Meaxl/customMidiController/documentation/pictures/breadboard_1.jpeg

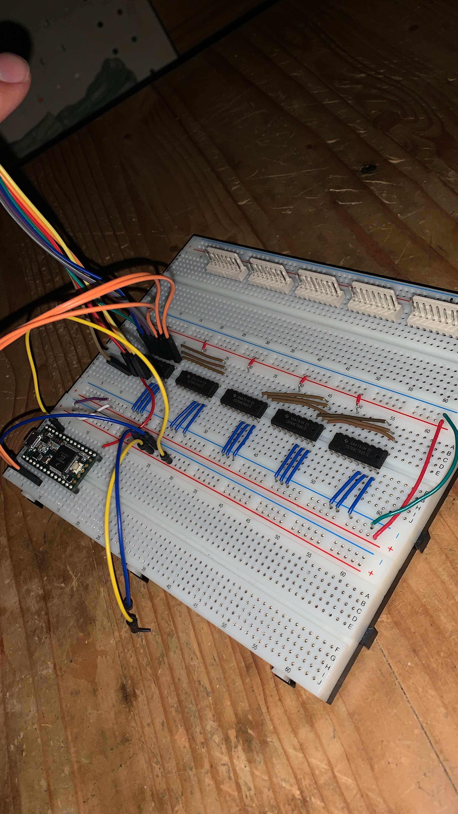
documentation/pictures/breadboard_1.jpeg
