Meaxl/customMidiController/documentation/pictures/breadboard_2.jpeg

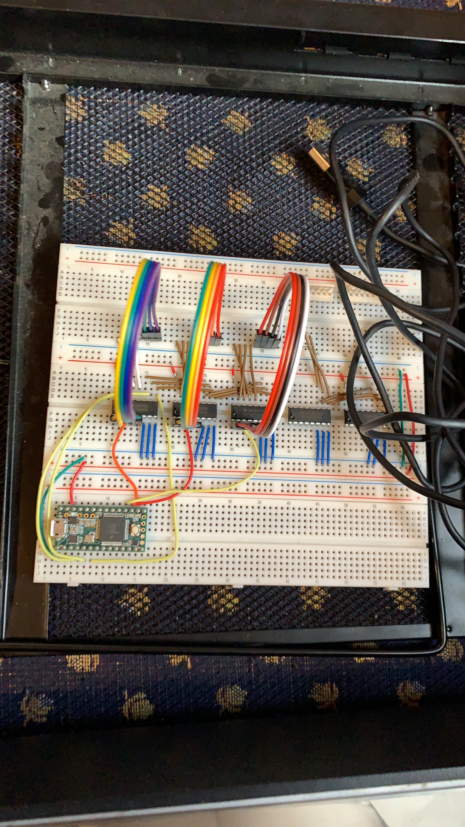
documentation/pictures/breadboard_2.jpeg
