Meaxl/customMidiController/documentation/pictures/frontplate_2.jpeg

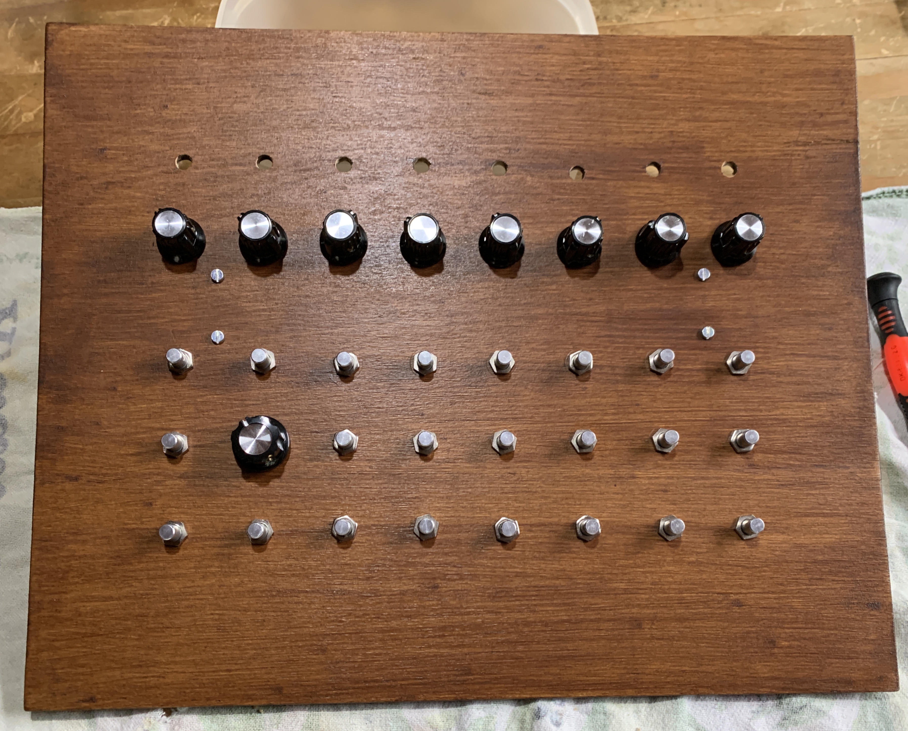
documentation/pictures/frontplate_2.jpeg
