Meaxl/customMidiController/documentation/pictures/frontplate_3.jpeg

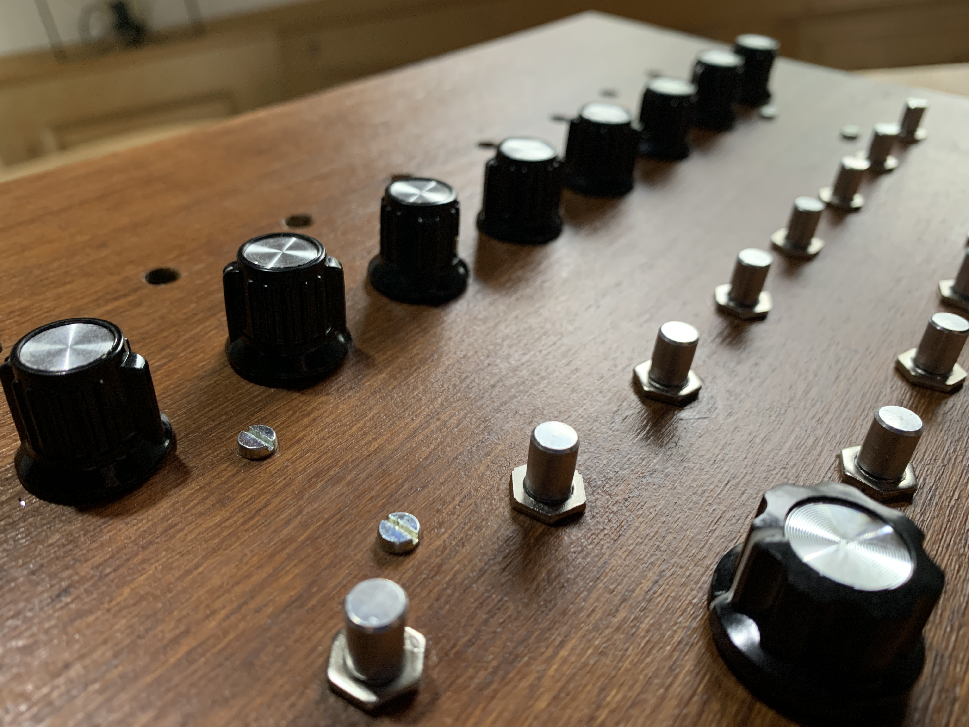
documentation/pictures/frontplate_3.jpeg
