Meaxl/customMidiController/documentation/pictures/frontplate_4.jpeg

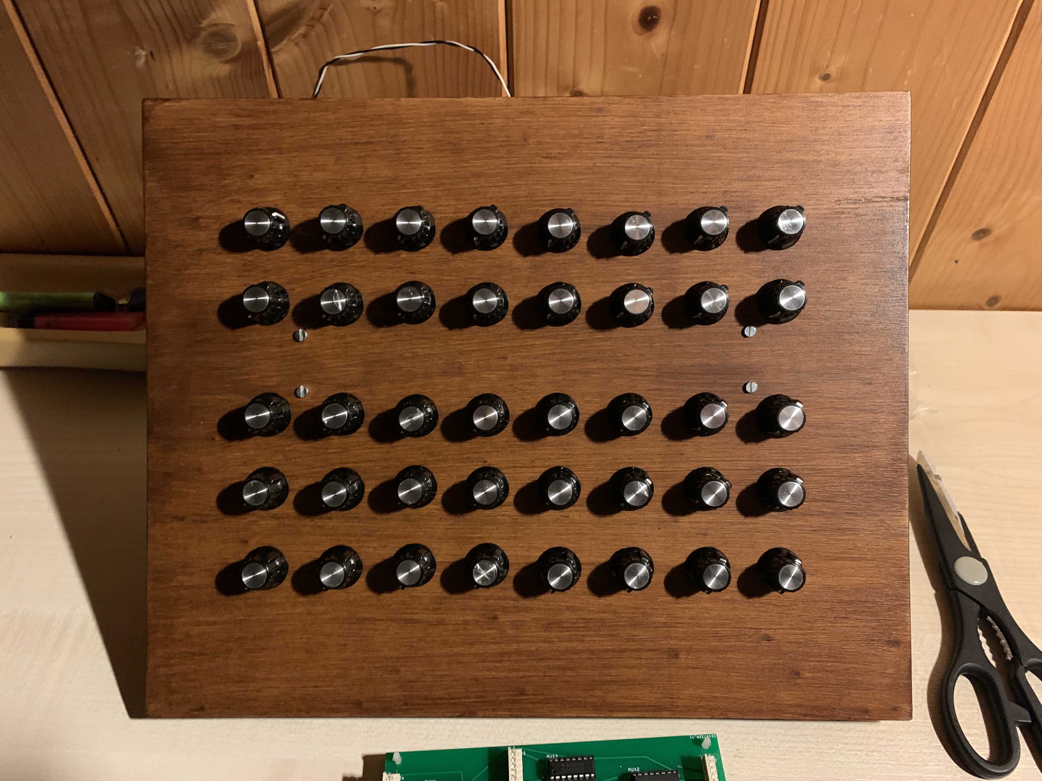
documentation/pictures/frontplate_4.jpeg
