Meaxl/customMidiController/documentation/pictures/pcb_1.jpeg

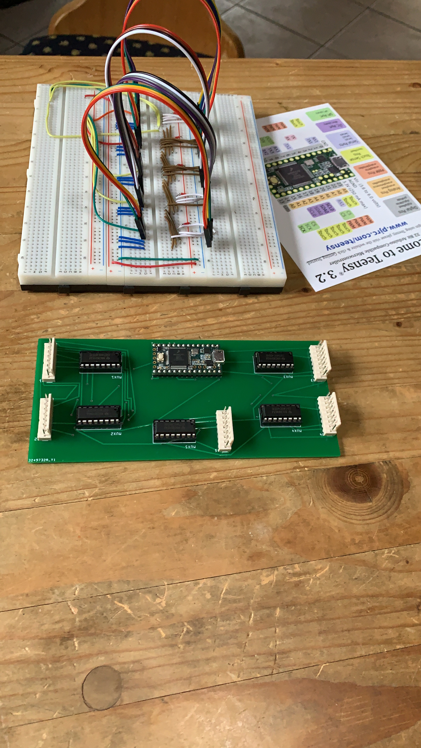
documentation/pictures/pcb_1.jpeg
