Meaxl/customMidiController/documentation/pictures/pcb_2.jpeg

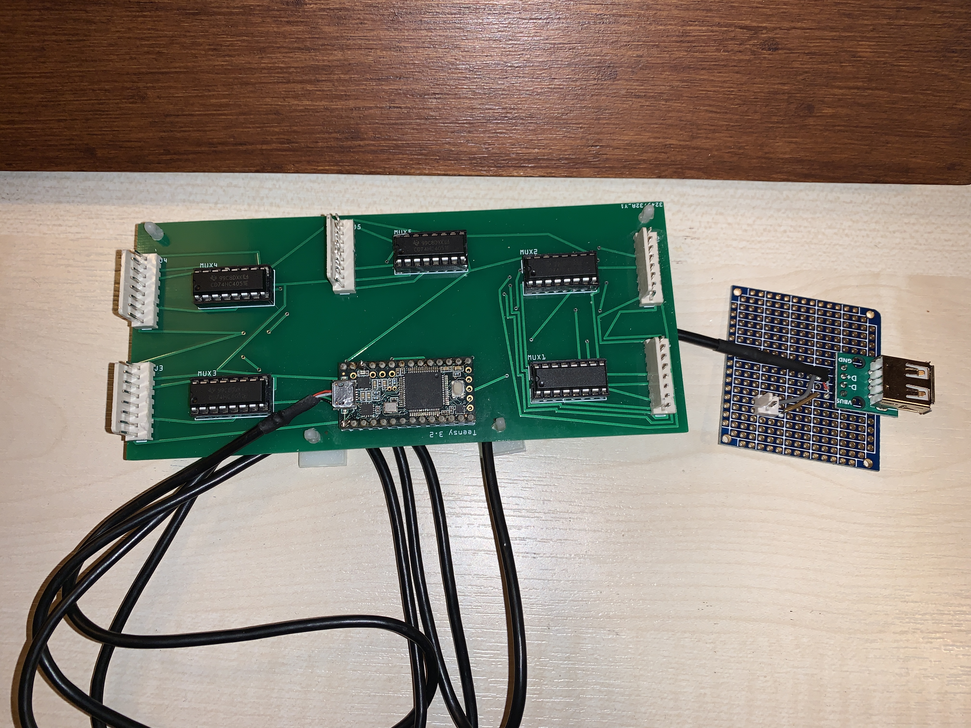
documentation/pictures/pcb_2.jpeg
