Meaxl/customMidiController/documentation/schematics/pcb.png

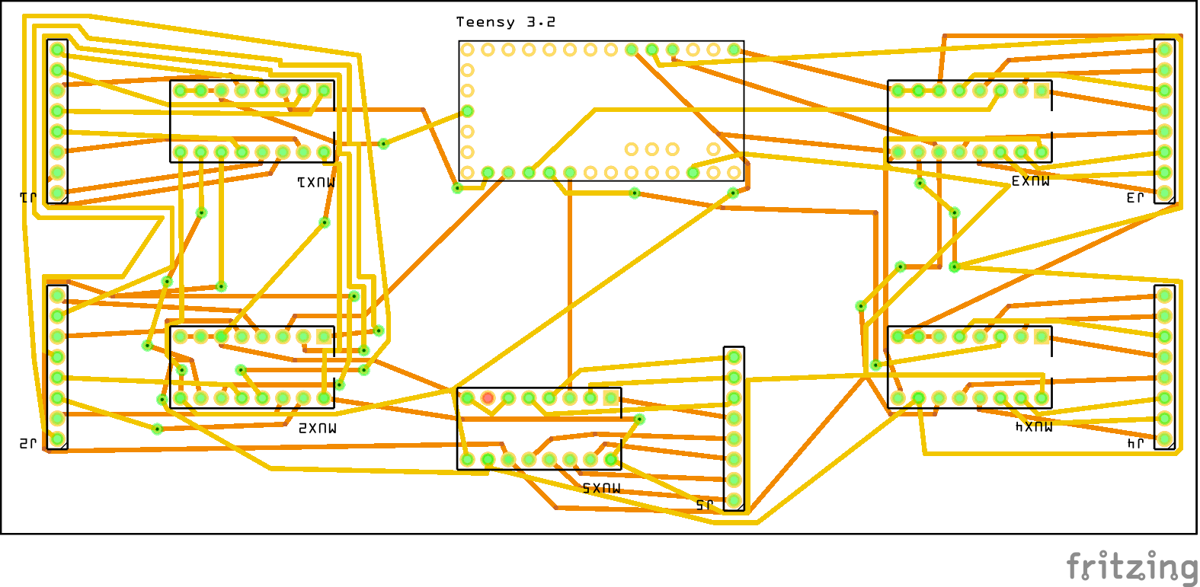
documentation/schematics/pcb.png
