Meaxl/customMidiController/documentation/schematics/schematic.png

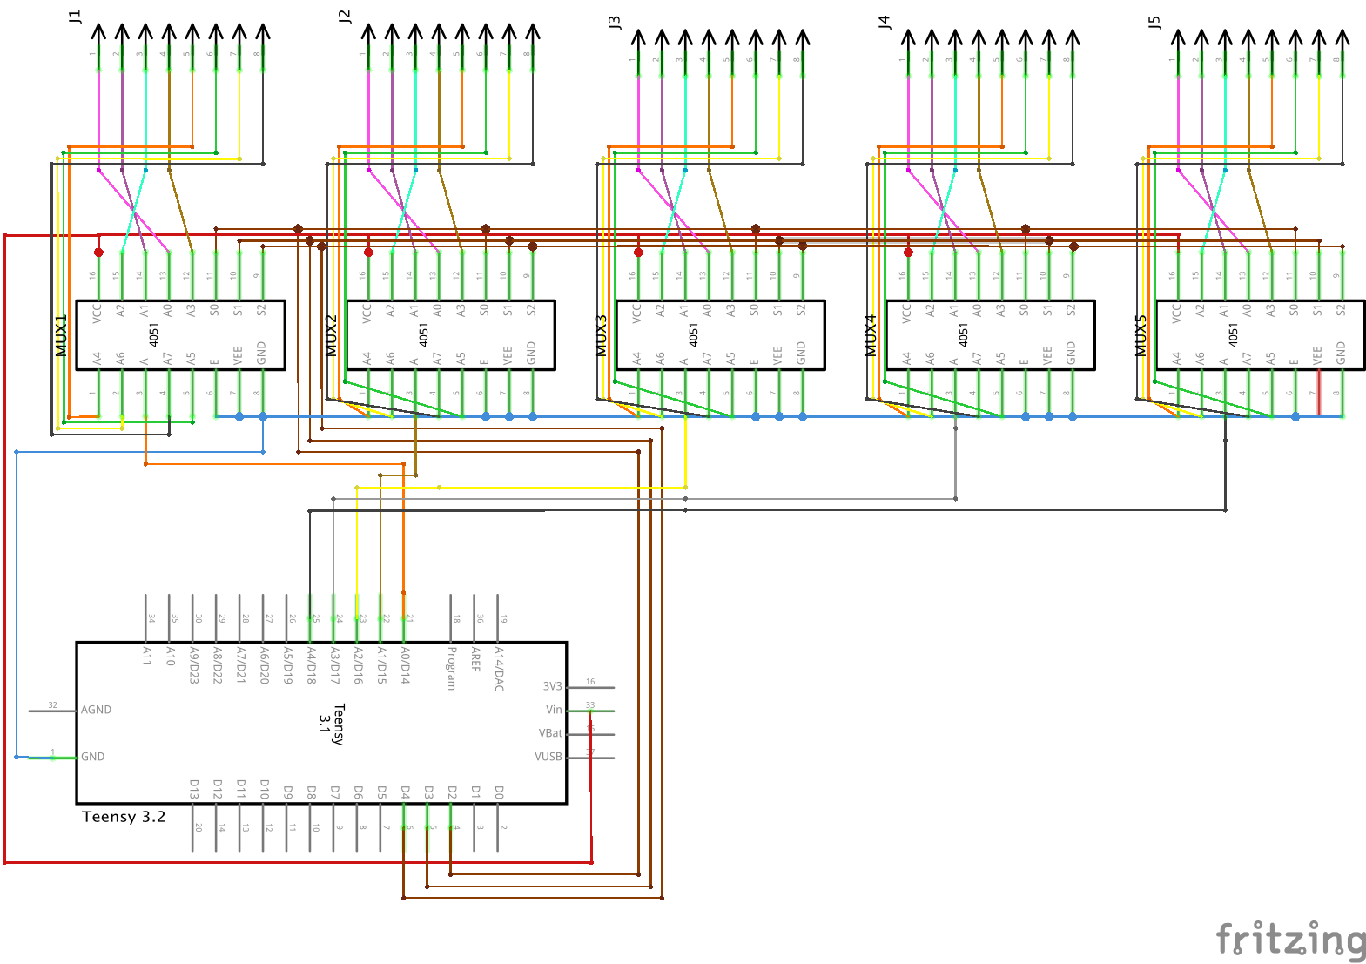
documentation/schematics/schematic.png
