Meaxl/customMidiController/documentation/pictures/soldering_1.jpeg

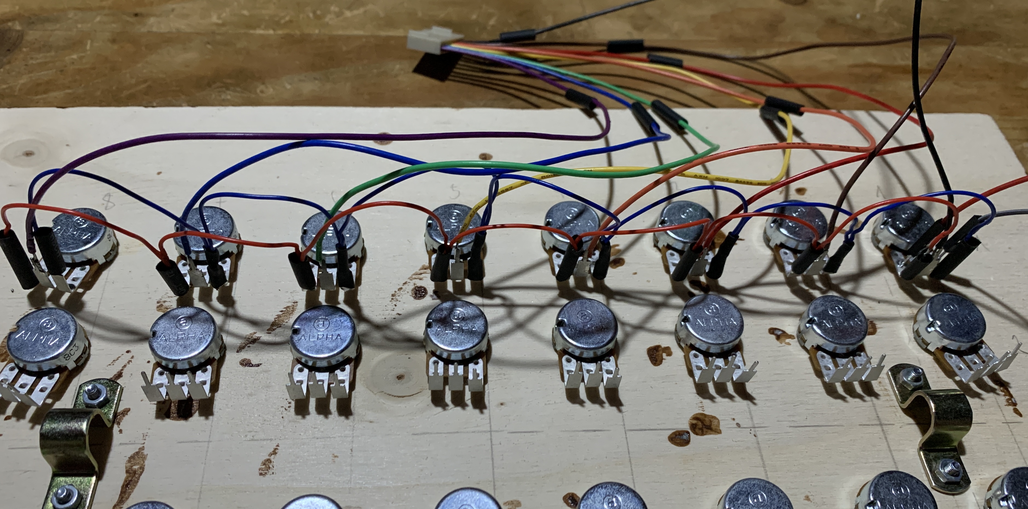
documentation/pictures/soldering_1.jpeg
