Meaxl/customMidiController/documentation/pictures/soldering_2.jpeg

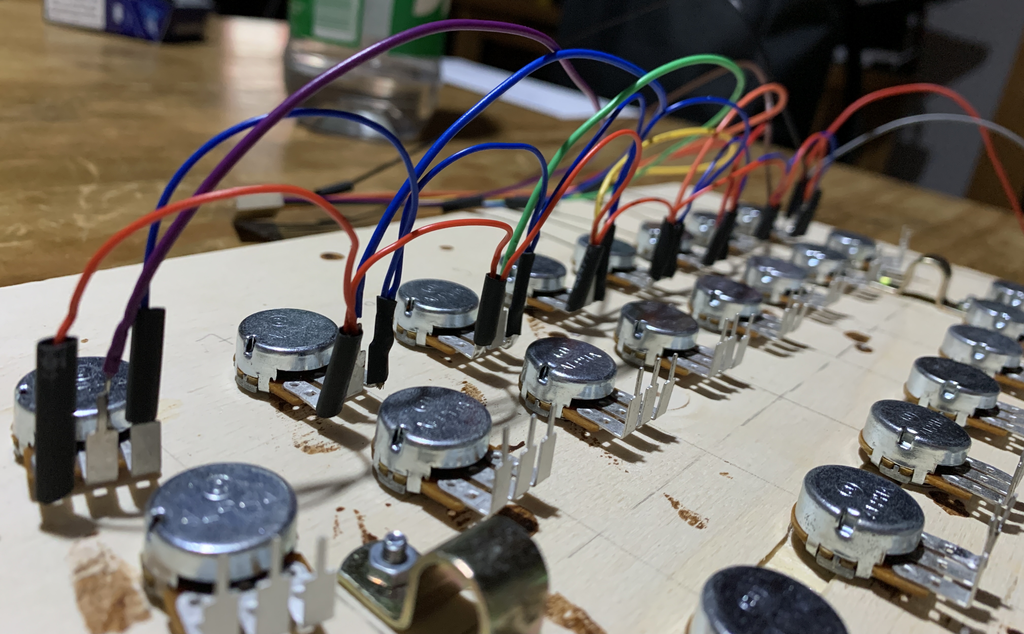
documentation/pictures/soldering_2.jpeg
