Meaxl/customMidiController/documentation/pictures/soldering_3.jpeg

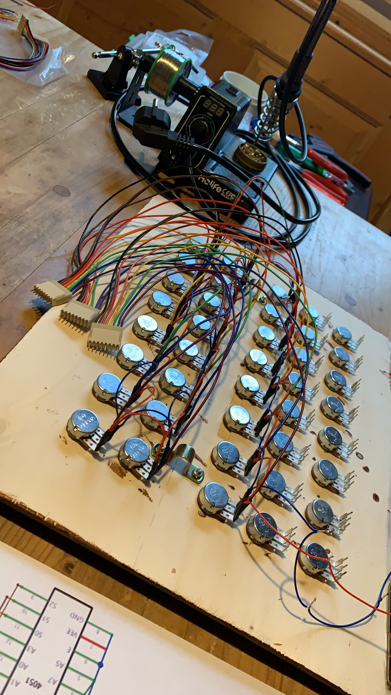
documentation/pictures/soldering_3.jpeg
