Meaxl/customMidiController/documentation/pictures/soldering_5.jpeg

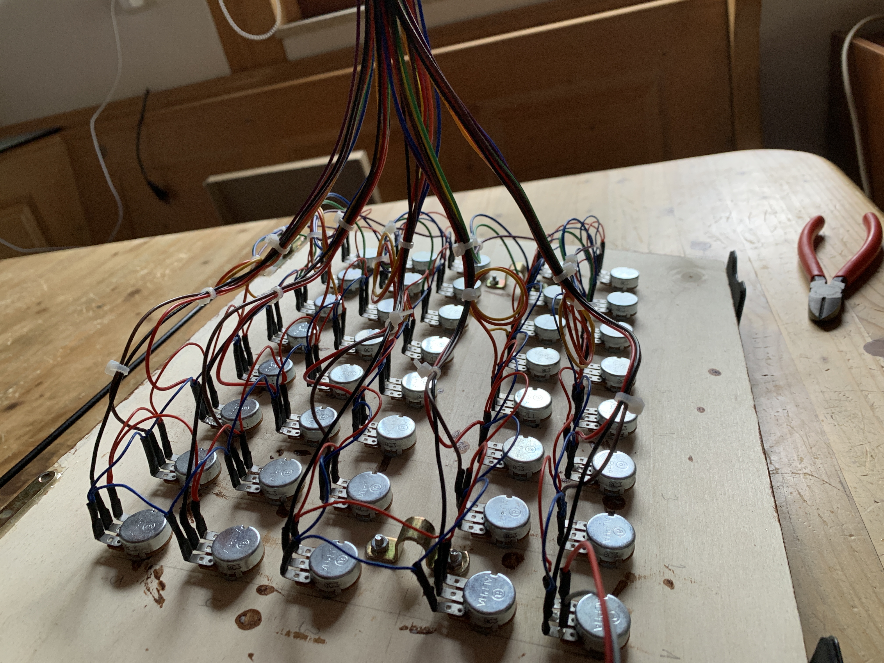
documentation/pictures/soldering_5.jpeg
