Meaxl/customMidiController/(commit log)

2020-08-31 adding latest working arduino code
2020-08-31 changing [count] to used [zaehler] (fix)
    [midiController_converted.ino]
2020-09-26 add schematic data
2020-10-16 Add pictures of soldering process
2020-10-16 Add pictures of pcb soldering
2020-10-16 Add schematic png versions
