Meaxl/customMidiController/documentation/pictures/breadboard_3.jpeg

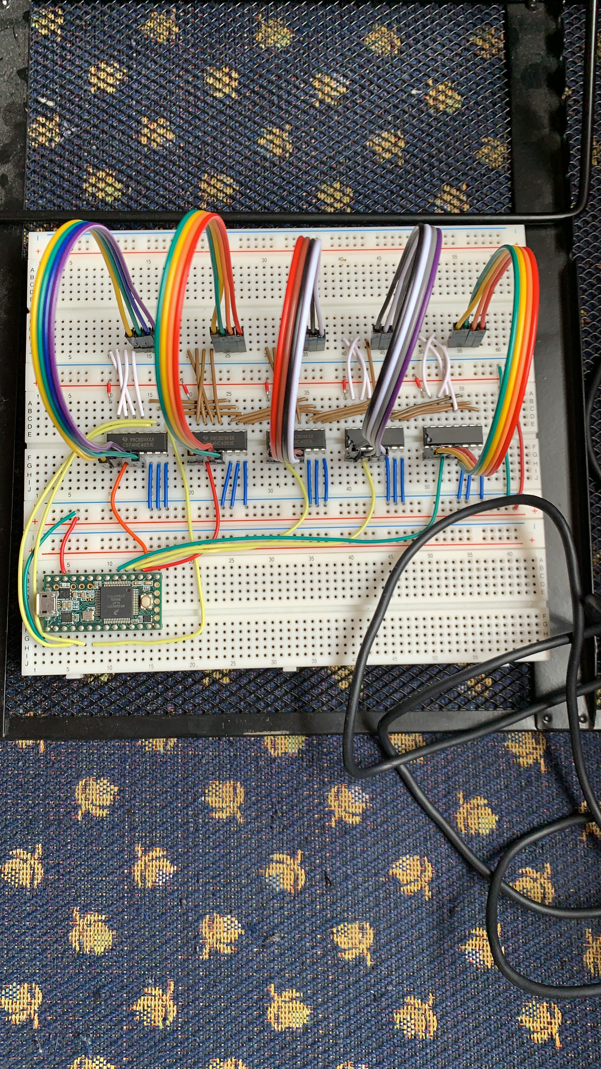
documentation/pictures/breadboard_3.jpeg
