Meaxl/customMidiController/documentation/pictures/frontplate_1.jpeg

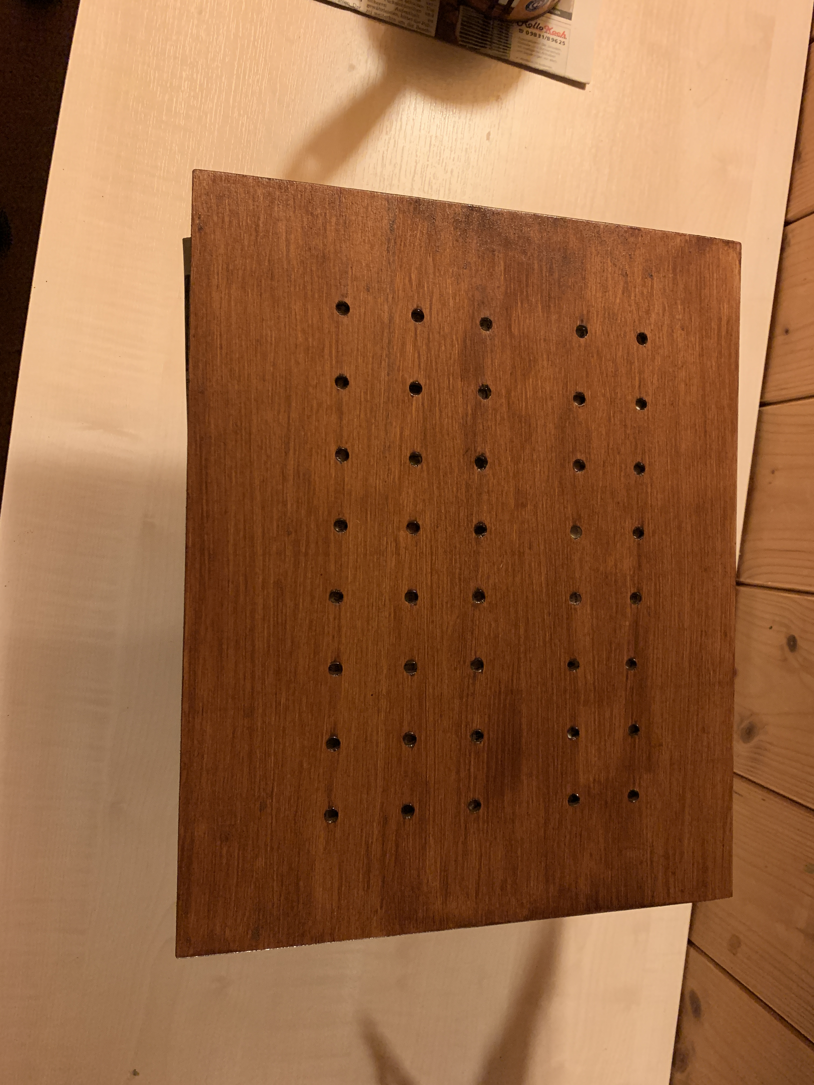
documentation/pictures/frontplate_1.jpeg
