Meaxl/customMidiController/documentation/pictures/soldering_4.jpeg

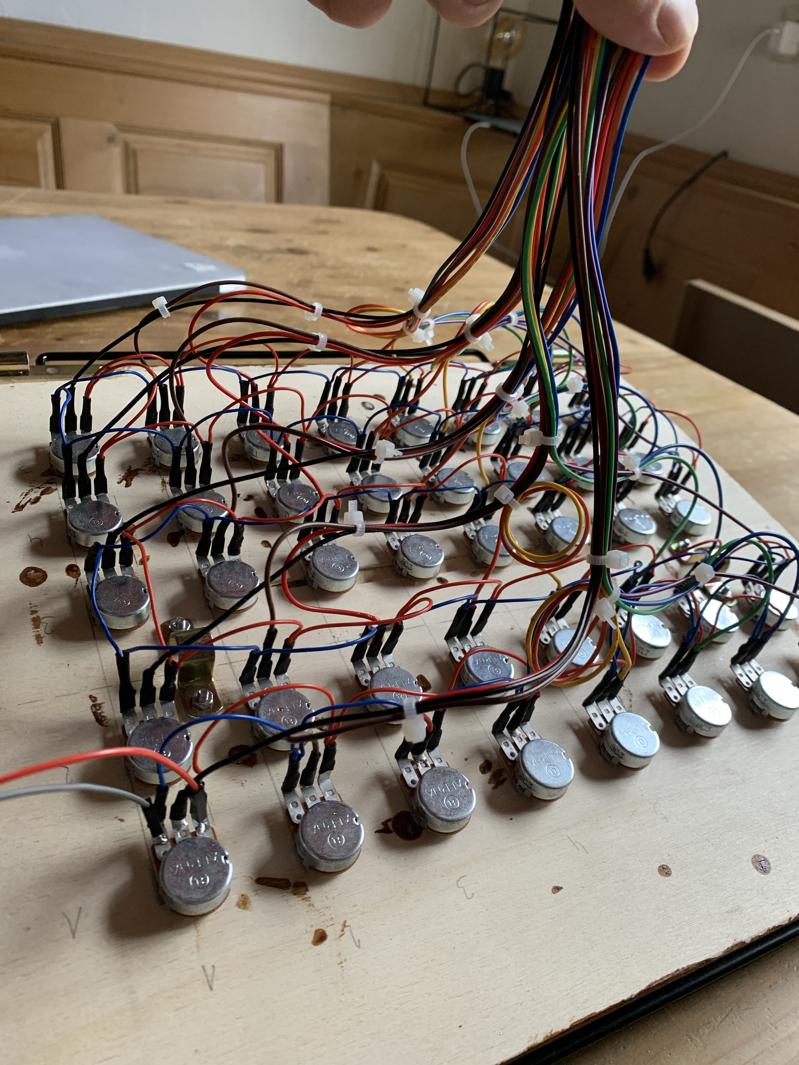
documentation/pictures/soldering_4.jpeg
