Meaxl/customMidiController/documentation/pictures/soldering_6.jpeg

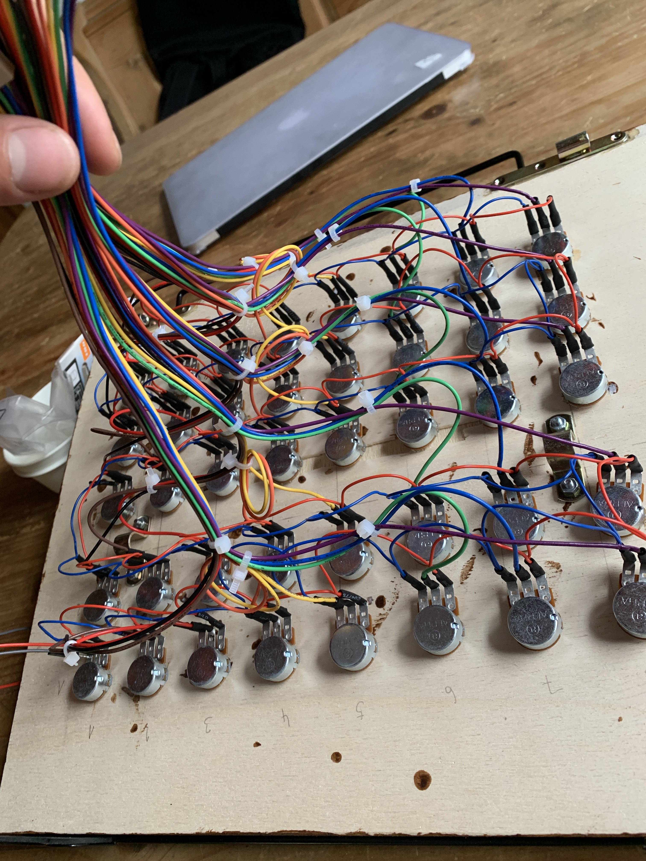
documentation/pictures/soldering_6.jpeg
