Meaxl/customMidiController/documentation/pictures/soldering_7.jpeg

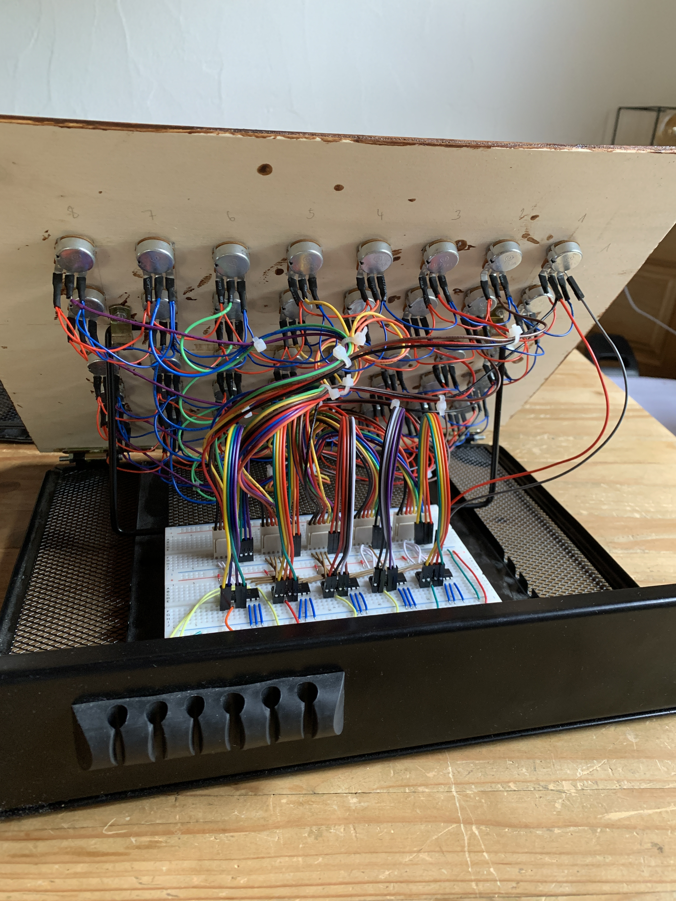
documentation/pictures/soldering_7.jpeg
